TomtheCoder2/Maturitaetsarbeit/README.md

# My Matura Project

### Code (laptop)
[here](/code)
[main](/code/src/bin/live_feed.rs)

### Code (arduino)
[here](/arduino_code/cpp/)
[main](/arduino_code/cpp/stepper_motor/stepper_motor.ino)

### Code (CNN and other)
[here](/code/python_code_ma)

### Documentation
[here](/documentation)

### Notes
[here](/notes)
