TomtheCoder2/Maturitaetsarbeit/notes/notes.md

high speed cameras
* https://www.e-consystems.com/4k-usb-camera.asp

* from [reddit](https://www.reddit.com/r/computervision/comments/sghdp8/suggestions_for_usb_based_high_speed_cameras/):
    * FLIR: https://www.flir.com/products/a6700-mwir/?vertical=rd%20science&segment=solutions (idk but maybe too expensive
    * Basler: https://www.baslerweb.com/en/shop/daa720-520uc-no-mount/?sort=position (looks very good)
    * Allied Vision: https://www.alliedvision.com/de/produktportfolio/kameraselektor/detail/goldeye/g-034-xswir-22-tec2/ (too expensive)
    * The Imaging Source: https://www.theimagingsource.com/en-us/product/board/37u/dfm37ux287ml/
    * Baumer: https://www.baumer.com/ch/en/product-overview/industrial-cameras-image-processing/industrial-cameras/cx-series/vcxg-vcxu-cameras/global-shutter-cameras/vcxg/vcxg-04c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
    * Ximea: https://www.ximea.com/en/products/usb3-vision-cameras-xiq-line/mq003cg-cm
    * SVS Vistek: https://www.svs-vistek.com/en/industrial-cameras/svs-camera-detail.php?id=fxo421CCX12-2C
    * BFS-U3-04S2C-CS: 0,4 MP, 522 FPS, Sony IMX287, Farbe

* Motors
  * https://www.distrelec.ch/en/stepper-motor-4nm-3000min-sup-sup-nema-23-sanyo-denki-say/p/30235550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
  * dc motor: https://eckstein-shop.de/Pololu-101-Metal-Gearmotor-37Dx65L-mm-12V-with-64-CPR-Encoder-Helical-Pinion-EN  

* Found a set:
  * cam: Alvium 1800 C-040c: https://www.digikey.ch/de/products/detail/allied-vision-inc/14216/11594990
  * lens: f=2.8mm https://commonlands.com/products/glass-low-distortion-3mm-m12-lens

* Arduino stuff
  * Arduino Mega 2560: https://store.arduino.cc/products/arduino-mega-2560-rev3
  * driver for dc motor: https://www.reichelt.com/ch/de/entwicklerboards-motorsteuerung-2-fach-l298n-debo-drv1-l298n-p282644.html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
  * driver for stepper motor: https://www.reichelt.com/ch/de/entwicklerboards-schrittmotorsteuerung-a4988-debo-drv-a4988-p282646.html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
