TomtheCoder2/Maturitaetsarbeit/documentation/src/main.tex

% Preamble
\documentclass[11pt,openany, english]{book}
\usepackage[a4paper, total={6in, 8in},headsep=0.5cm]{geometry}

% Packages
\usepackage{amsmath}
\usepackage{tikz}
\usetikzlibrary{shapes.geometric, arrows}
\usetikzlibrary{decorations.markings}
\usetikzlibrary{decorations.pathmorphing,patterns}
\usepackage{wrapfig}
%\usepackage{amstex}
\usetikzlibrary{calc}
\usepackage{fancyheadings}
\usepackage{mathtools}
\usepackage{transparent}
\usepackage{graphicx}
\usepackage{float}
\usepackage{subcaption}
\usepackage [autostyle, english = american]{csquotes}
\usepackage{hyperref}
\usepackage{siunitx}
\hypersetup{
    colorlinks,
    linkcolor={blue!50!black},
    citecolor={blue!50!black},
    urlcolor={blue!80!black}
}
\usepackage{pgfplots}
\usepackage{pgfplotstable}
\usepackage{babel}[english]
\usepackage{cancel}
%\usepackage[super]{natbib}
\pgfplotsset{compat=1.12}
%\usepackage{biblatex}
\usepackage[backend=bibtex, urldate=long,
    sorting=none,
    maxnames=10,
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
    template,this,thread_local,throw,true,try,typedef,typeid,typename,
    union,unsigned,using,virtual,void,volatile,wchar_t,while
},
    keywordstyle=\color{PurpleKeyword},
    ndkeywords={
    std,string,vector,map,set,unordered_map,unordered_set,shared_ptr,
    unique_ptr,weak_ptr,array,optional,variant,tuple,pair,ostream,
    istream,cout,cin,endl
},
    ndkeywordstyle=\color{RedTypename},
    comment=[l][\color{GrayComment}\slshape]{//},
    morecomment=[s][\color{GrayComment}\slshape]{/*}{*/},
    stringstyle=\color{GreenString},
    string=[b]"
}

% get name of current section
\makeatletter
\newcommand*{\currentname}{\@currentlabelname}
\makeatother

% get name of current chapter
\let\Chaptermark\chaptermark
\def\chaptermark#1{\def\Chaptername{#1}\Chaptermark{#1}}

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

% #1 number of teeth
% #2 radius intern
% #3 radius extern
% #4 angle from start to end of the first arc
% #5 angle to decale the second arc from the first
\newcommand{\gear}[5]{%
    \foreach \i in {1,...,#1} {%
        [rotate=(\i-1)*360/#1]
        (0:#2) arc (0:#4:#2)
        [rounded corners=1.5pt]
        -- (#4+#5:#3)
        arc (#4+#5:360/#1-#5:#3)
        -- (360/#1:#2)
    }
}

\newcommand{\mycancel}[2]{\overset{#1}{\cancel{#2}}}
\newcommand{\cancelunder}[2]{\underset{#1}{\cancel{#2}}}
\renewcommand{\deg}[0]{\ensuremath{^\circ}}
\newcommand{\abs}[1]{\left|#1\right|}
\newcommand{\cfbox}[2]{%
    \colorlet{currentcolor}{.}%
    {\color{#1}%
    \noindent\fbox{\vbox{\hsize\dimexpr\hsize-2\fboxsep\relax
    #2
    }}}%
}
\newcommand{\todo}[1]{\begin{center}\cfbox{red}{\textcolor{red}{Todo: #1}}\end{center}}

\oddsidemargin=-1cm
\evensidemargin=-1cm
\voffset=-1.5cm
\textheight=26cm
\textwidth=18cm

\thispagestyle{fancy}

\fancyhf{} % clear all fields
\newcommand{\footl}{\Chaptername}
\newcommand{\bottompage}{-- \thepage\ --}

\date{\today}

\fancypagestyle{plain}{%
    \fancyhf{}
    \fancyhead[L]{\rule[-2ex]{0pt}{2ex}\small Matura Project}
    \fancyhead[R]{\small Jan Wilhelm, 6e}
    \fancyfoot[L]{\small \footl}
    \fancyfoot[C]{\bottompage}
    \fancyfoot[R]{\small \today}
    \renewcommand{\headrulewidth}{0.2pt}
    \renewcommand{\footrulewidth}{0.2pt}}
\pagestyle{plain}

\title{
    \linespread{1.8}
    Jan Wilhelm, 6e\\
    \linespread{1}
    \Huge \textbf{Designing, assembling and programming a foosball goalkeeper robot}\\
    \linespread{1.8}
    \vspace{0.5cm}
    \begin{figure}[H]
        \centering
        
        \caption*{}
        \label{fig:title}
    \end{figure}
    \vspace{-0.8cm}
    \Large
    \textbf{Maturitätsarbeit}\\
    Kantonsschule Hohe Promenade, Gymnasium, Zürich 2024/2025\\
    \textbf{Supervisor:} Clemens Pohle\\
    \textbf{Advisor:} Dr. Hugo Leonel Cabrera Cifuentes\\
    \linespread{1}}
% custom date 17.12.2024
%\date{December 17, 2024}

%\linespread{1.8}

% Document
\begin{document}

    \makeatletter
    \voffset=-1.5cm
    \begin{titlepage}
        \thispagestyle{fancy}
        \renewcommand{\headrulewidth}{0pt}
        \renewcommand{\footrulewidth}{0pt}
        \lhead{}
        \rhead{}
        \rfoot{}
        \cfoot{} % this is to remove the page number
        \hbox{}\vfill
        \begin{center}
        {\LARGE\@title}
            \\[3em]
            {\large\@author}\\[1.75em]
            {\large\@date}
        \end{center}
        \vspace{3cm}\vfill
    \end{titlepage}
    \makeatother
    \voffset=-2.0cm
    \textheight=26.4cm

    % todo: main questions: We/I or unpersonal?
    % -> I always use I
%    \maketitle
%    \mewpage

    \shipout\null

    \renewcommand{\bottompage}{}
    \tableofcontents
    \newpage

    ~\\
    \section*{Abstract}
    \begin{abstract}
        Whether a machine can beat a human in a specific task is as old as the first machines.
        Machines have already surpassed humans in many areas, such as calculators, chess,
        and even driving cars.
        But what about foosball (table soccer)?
        This project demonstrates the development of a machine-controlled goalkeeper for foosball,
        capable of reliably stopping slow balls.
        While the goalkeeper occasionally struggles with the timing required for fast balls and shooting,
        the results serve as a proof of concept.
        The machine uses a camera to monitor the game from below and motors to move the goalkeeper.
        Although only basic AI was employed,
        the approach shows promise for extending similar designs to other players on the table.
        This work highlights the potential of automated systems in fast-paced, real-time scenarios,
        while acknowledging room for improvement to enhance performance and timing.
    \end{abstract}
    \vspace{1cm}

    \section*{Acknowledgements}
    I would like to express my heartfelt gratitude to the following individuals and organizations for their invaluable support and contributions to my project:
    \begin{enumerate}
        \item My parents, Bettina Jenny und Dirk Wilhelm
        \begin{itemize}
            \vspace{-0.2cm}
            \item Email: \href{mailto:wilk@zhaw.ch}{wilk@zhaw.ch} (Father) \& (private) (Mother)
            \item Contribution: Financial support, technical advice, and encouragement throughout this journey.
            \vspace{-0.2cm}
        \end{itemize}
        \item Ilena Teng and her father Robert Teng
        \begin{itemize}
            \vspace{-0.2cm}
            \item Email: (private)
            \item Contribution: Technical assistance with soldering and sensor integration.
            \vspace{-0.2cm}
        \end{itemize}
        \item FabLab Zürich
        \begin{itemize}
            \vspace{-0.2cm}
            \item Email: \href{mailto:vorstand@zurich.fablab.ch}{vorstand@zurich.fablab.ch}
            \item Contribution: Providing access to laser cutting, 3D printing, and CNC machining, and helpful guidance by the team members.
            \vspace{-0.2cm}
        \end{itemize}
        \item Gabriel Schneider from ZHAW
        \begin{itemize}
            \vspace{-0.2cm}
            \item Email: \href{mailto:gabriel.schneider@zhaw.ch}{gabriel.schneider@zhaw.ch}
            \item Contribution: Expertise and support in the design process.
            \vspace{-0.2cm}
        \end{itemize}
        \item Clemens Pohle, my supervisor
        \begin{itemize}
            \vspace{-0.2cm}
            \item Email: \href{mailto:clemens.pohle@kshp.ch}{clemens.pohle@kshp.ch}
            \item Contribution: Continuous supervision and insightful feedback, which greatly improved the quality of this documentation.
            \vspace{-0.2cm}
        \end{itemize}
    \end{enumerate}
    Thank you all for your generosity and dedication, which made this project possible.

    \vspace{1cm}
    \section*{Statement of Originality}
    Ich, Jan Wilhelm aus der Klasse 6e, erkläre hiermit, dass ich die vorliegende Arbeit "Designing, assembling and programming a foosball goalkeeper robot" selbständig und ohne Benützung anderer als der angegebenen Quellen oder Hilfsmittel verfasst bzw. gestaltet habe.
    \vspace{1cm}\\
    Ort, Datum: \hspace{6cm} Unterschrift:

    \chapter{Introduction}\label{ch:introduction}
    \renewcommand{\bottompage}{-- \thepage\ --}
    \setcounter{page}{1}
    \input{introduction}

    \chapter{Objectives}\label{ch:objectives}
    \input{objectives}

    \chapter{Calculations}\label{ch:calculations}
    \input{calculations}

    \chapter{Mechanics}\label{ch:mechanics}
    \input{mechanics}

    \chapter{Construction}\label{ch:construction}
    \input{construction}

    \chapter{Electronics}\label{ch:electronics}
    \input{electronics}

    \chapter{Software}\label{ch:software}
    \input{software}

    \chapter{Results}\label{ch:results}
%    \todo{Finish project to get latest results}
    \input{results}

    \chapter{Conclusion}\label{ch:conclusion}
    \input{conclusion}

    \newpage
    \renewcommand{\footl}{References}

    \bibliographystyle{abbrv}
    \printbibliography

%    \newpage
%    \bibliographystyle{unsrt}
%%    \renewcommand\refname{Quellen}
%    \makeatletter
%    \renewcommand\@biblabel[1]{\textbullet}
%    \makeatother
%    \bibliography{sources} % Entries are in the refs.bib file
%    \printbibliography
%    \nocite{*}

    \newpage

    \chapter{Appendix}\label{ch:appendix}
    \renewcommand{\footl}{\Chaptername}
    \input{appendix}

\end{document}

% pdflatex -interaction=nonstopmode -output-directory=output src/main.tex
