TomtheCoder2/Maturitaetsarbeit/documentation/src/foosball_system.tex

%! Author = janwi
%! Date = 01.12.2024

%! Author = janwi
%! Date = 19.11.2024

% Preamble
\documentclass[11pt]{article}
\usepackage[a4paper, total={6in, 8in},headsep=1cm]{geometry}
\usepackage{fancyhdr}
\usepackage[german]{datetime}
\usepackage{amsmath}
\usepackage{blindtext}
\usepackage{tikz}

\newdate{date}{19}{11}{2024}

\oddsidemargin=-1.5cm
\voffset=-1.7cm
\textheight=26cm
\textwidth=19cm

\fancyhf{} % clear all fields
\newcommand{\footl}{left bottom text}
\newcommand{\headl}{left top text}

\fancypagestyle{plain}{%
    \fancyhf{}
    \fancyhead[L]{\rule[-2ex]{0pt}{2ex}\small \headl}
    \fancyhead[R]{\small Jan Wilhelm 6e}
    \fancyfoot[L]{\small \footl}
    \fancyfoot[C]{-- \thepage\ --}
    \fancyfoot[R]{\small \date{\displaydate{date}}}
    \renewcommand{\headrulewidth}{0.2pt}
    \renewcommand{\footrulewidth}{0.2pt}}
\pagestyle{plain}

\title {\vspace{-1.5cm} \huge \textbf {Title}\\
\newdateformat\date{\displaydate{date}}
}

% #1 number of teeth
% #2 radius intern
% #3 radius extern
% #4 angle from start to end of the first arc
% #5 angle to decale the second arc from the first
\newcommand{\gear}[5]{%
    \foreach \i in {1,...,#1} {%
        [rotate=(\i-1)*360/#1]
        (0:#2) arc (0:#4:#2)
        [rounded corners=1.5pt]
        -- (#4+#5:#3)
        arc (#4+#5:360/#1-#5:#3)
        -- (360/#1:#2)
    }
}

% Document
\begin{document}
    \vspace{-1cm}
    \maketitle
    \vspace{-1cm}

    % create a simple drawing of the system
    \begin{center}
        \begin{tikzpicture}
            \draw (7, 10) rectangle (0, 0);
            \begin{scope}
                [shift={(3.5, 0)}]
                \node[below] {Foosball table};
            \end{scope}
%        draw a circle in the middle and an arrow pointing there labling it the camera
            \draw[fill=blue!30] (3.5, 5) circle (0.5);
            \draw[<-] (4.1, 5) -- (8, 5) node[above] {Camera};
%            pc
            \draw[fill=orange!30] (10, 9) rectangle (12, 11) node[pos=0.5] {PC}
%            cable from camera to pc
            \draw[->] (3.5, 5.5) -- (3.5, 6) -- (11, 6) -- (11, 8.8);
%            controler (Arduino)
            \draw[fill=orange!30] (6, 10) rectangle (9, 11) node[pos=.5]{Controller unit};
            \draw[->] (10, 10.5) -- (9.2, 10.5);
%            move motor
            \draw[fill=blue!30] (7, 6.5) rectangle (8.5, 8) node[pos=.5,
text width=1.5cm,align=center
] {Move motor}
            \begin{scope}
                [shift={(7.75, 7.25)}, scale=0.4]
                \draw \gear{18}{2}{2.4}{10}{2}
            \end{scope}
            \draw[fill, black] (7.75, 7.25) circle (0.03);
            \draw[<-](7.75, 8.2) -- (7.75, 10);
            \draw (0, 8.75) rectangle (9, 8.25) node[pos=.5] {Tube};
            \draw[fill=blue!30] (0, 9.25) rectangle (-1, 7.75) node[midway, left, shift={(-.5, 0)}] {Shoot motor};
            \draw[->] (6, 10.5) -- (-0.5, 10.5) -- (-0.5, 9.45);
            \draw (3.5, 8.5) circle (0.5);
        \end{tikzpicture}
    \end{center}

\end{document}
