TomtheCoder2/Maturitaetsarbeit/documentation/src/data_matracies.tex

\documentclass[11pt]{report}
\usepackage{graphics}
\usepackage{graphicx}

\textheight=21cm
\oddsidemargin=-2.5cm
\textwidth=18.5cm

\begin{document}
    \setlength{\fboxsep}{0pt}%
    \setlength{\fboxrule}{1pt}%

    \begin{table}[]
        \begin{tabular}{ll}
            \fbox{}
            &  \fbox{} \\
            &                                                       \\
            \fbox{}
            & \fbox{} \\

        \end{tabular}
    \end{table}

\end{document}
