TomtheCoder2/Maturitaetsarbeit/code/formulas/img_1.png

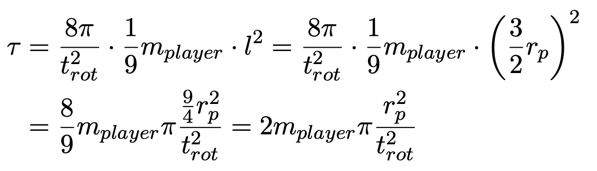
code/formulas/img_1.png
