TomtheCoder2/Maturitaetsarbeit/code/output.png

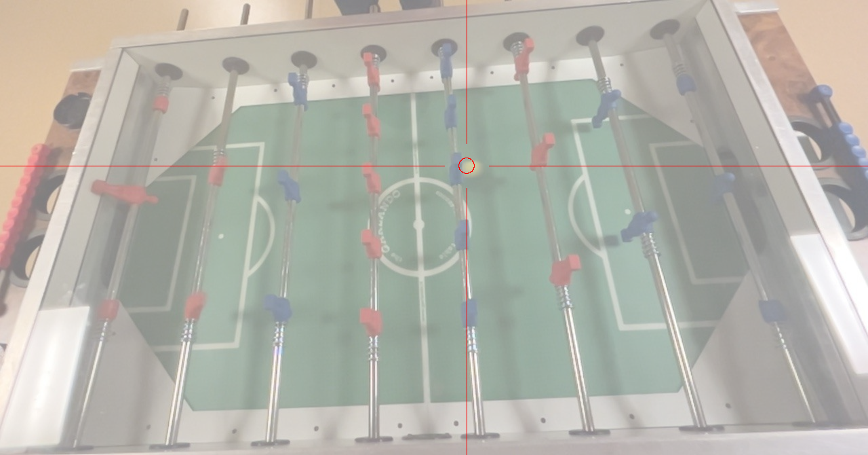
code/output.png
