TomtheCoder2/Maturitaetsarbeit/code/python_code_ma/base_img6.png

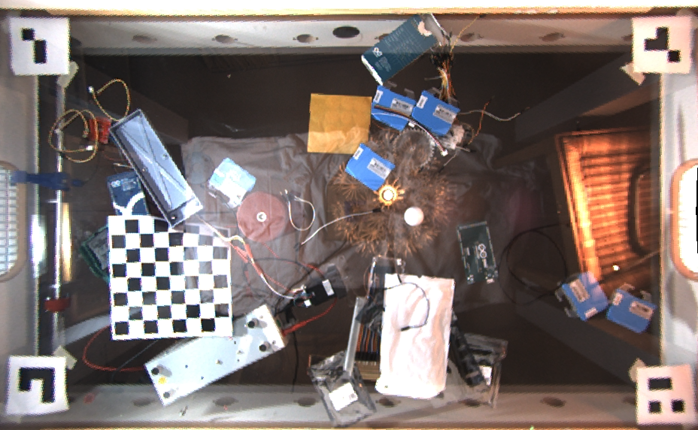
code/python_code_ma/base_img6.png
