TomtheCoder2/Maturitaetsarbeit/code/raw.jpg

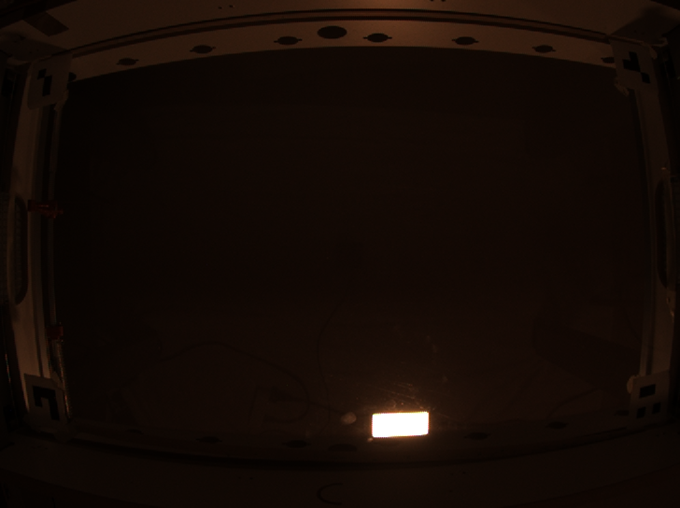
code/raw.jpg
