TomtheCoder2/Maturitaetsarbeit/code/src/gpu/input_image.png

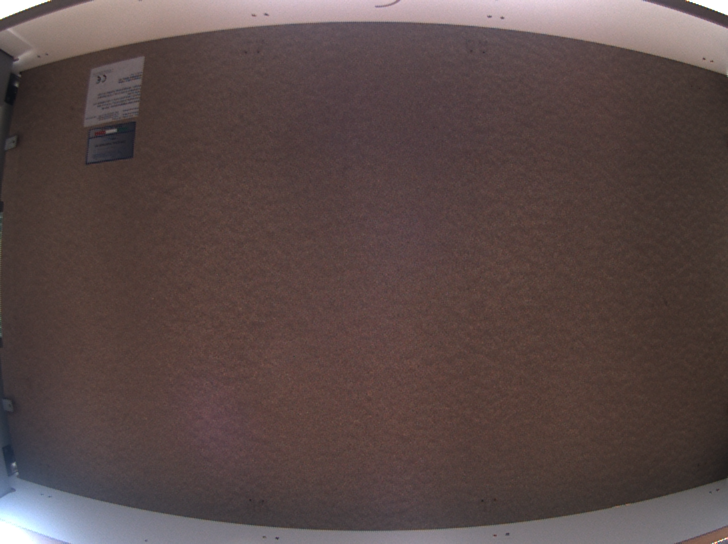
code/src/gpu/input_image.png
