TomtheCoder2/Maturitaetsarbeit/code/src/gpu/output_image.png

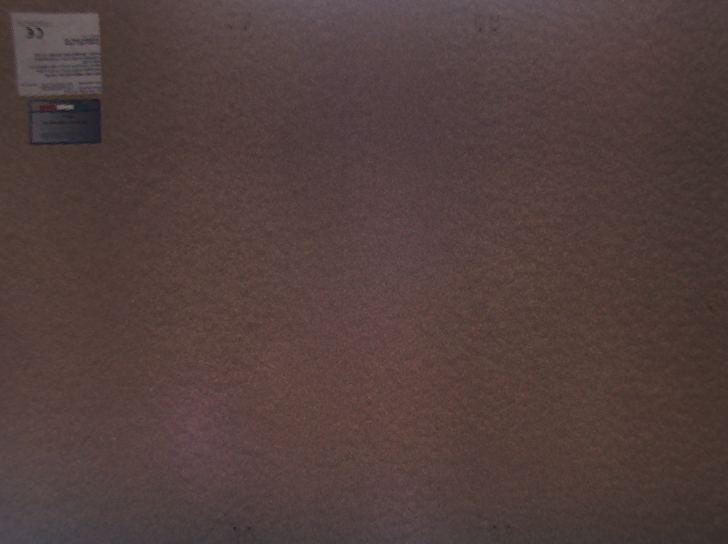
code/src/gpu/output_image.png
