TomtheCoder2/Maturitaetsarbeit/documentation/images/datamatrix_0.png

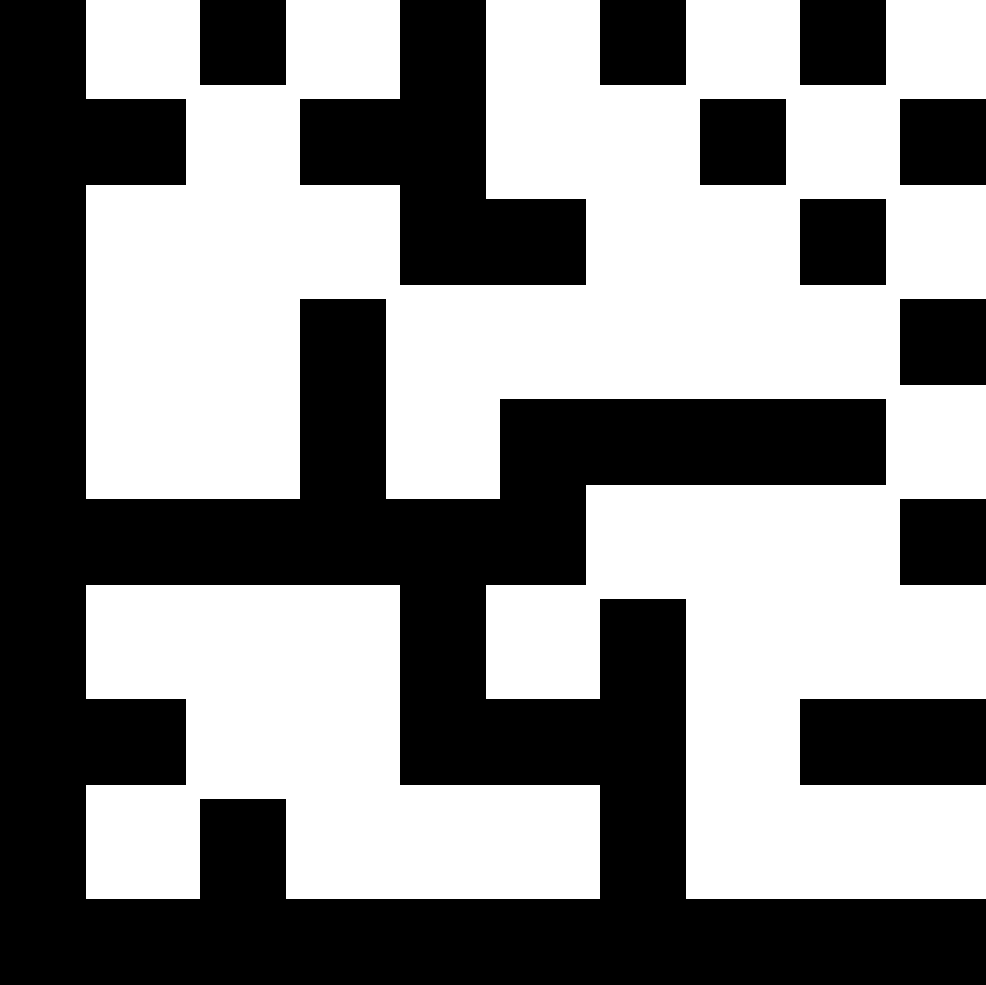
documentation/images/datamatrix_0.png
