TomtheCoder2/Maturitaetsarbeit/documentation/images/datamatrix_1.png

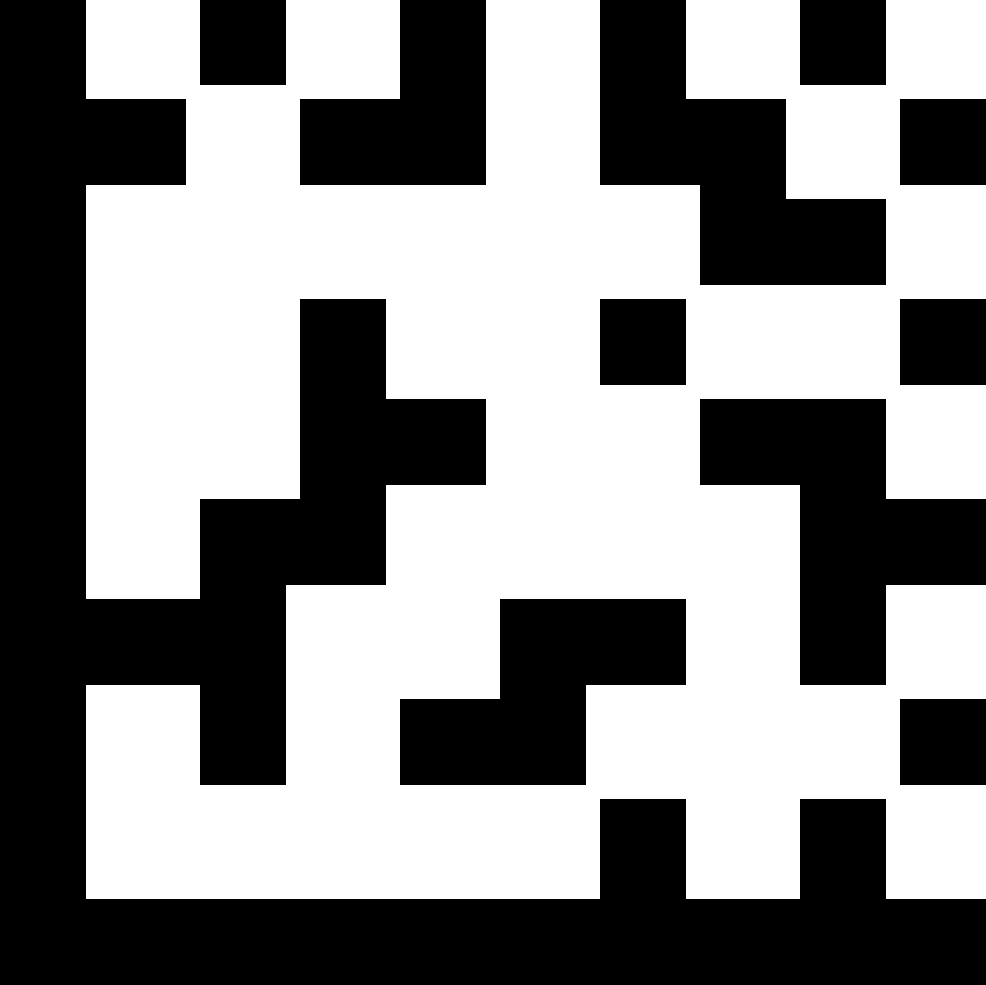
documentation/images/datamatrix_1.png
