TomtheCoder2/Maturitaetsarbeit/documentation/images/datamatrix_2.png

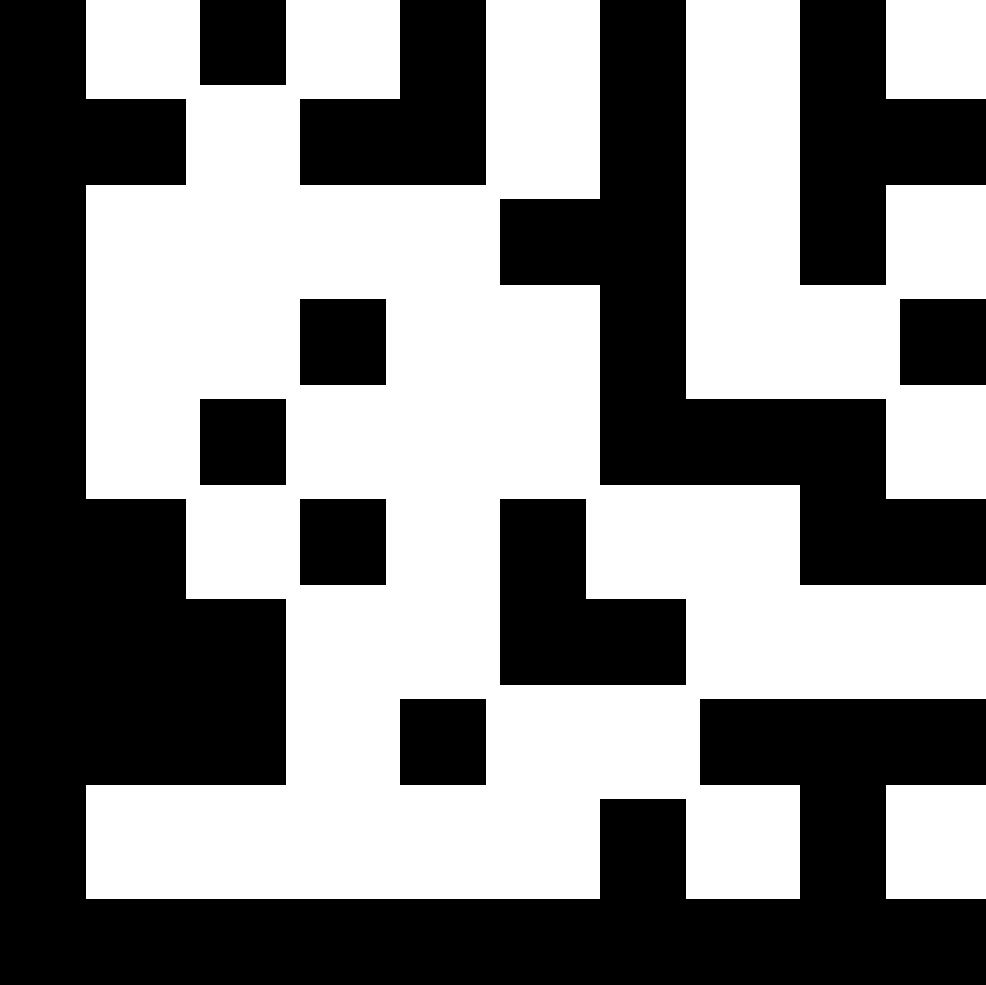
documentation/images/datamatrix_2.png
