TomtheCoder2/Maturitaetsarbeit/documentation/images/datamatrix_3.png

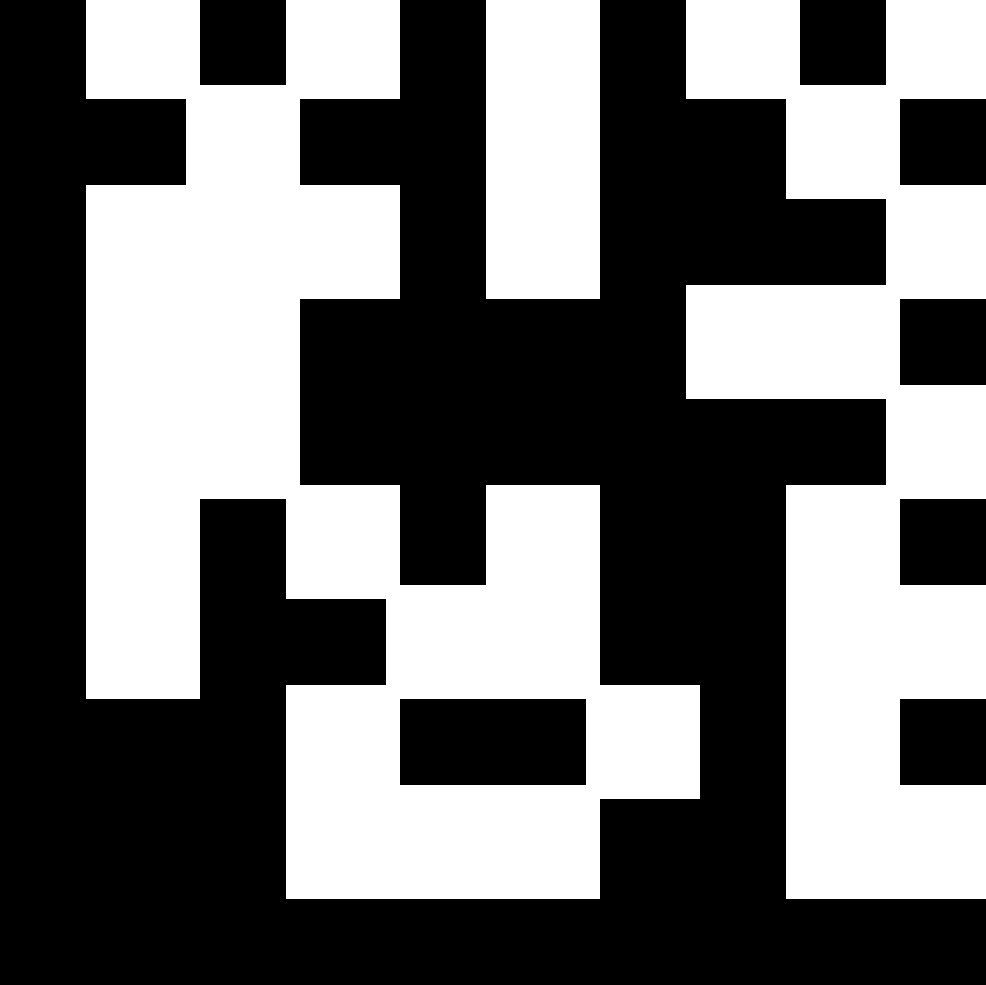
documentation/images/datamatrix_3.png
