TomtheCoder2/Maturitaetsarbeit/documentation/photos/cnc_shield_c.jpeg

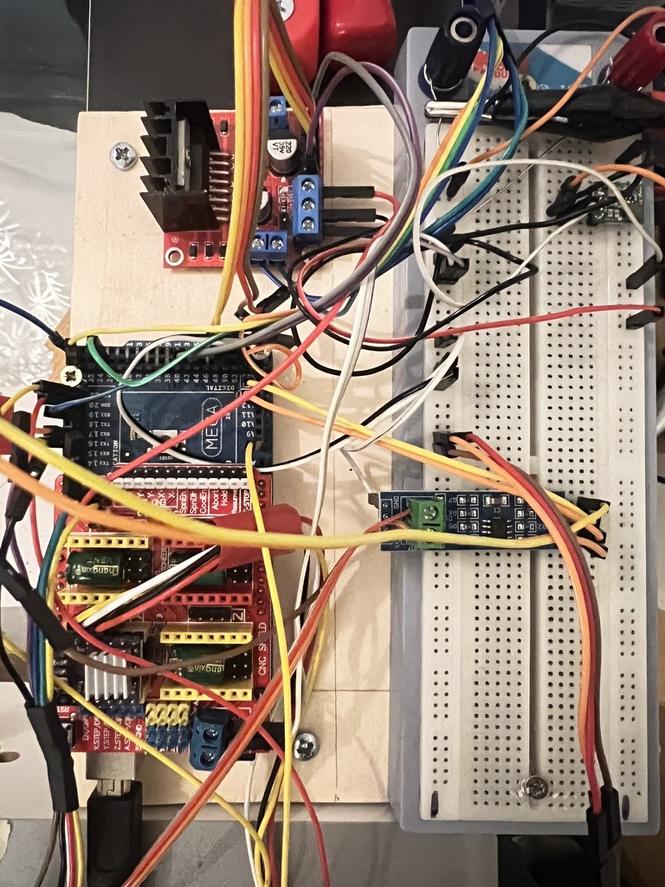
documentation/photos/cnc_shield_c.jpeg
