TomtheCoder2/Maturitaetsarbeit/documentation/photos/example8_cropped.png

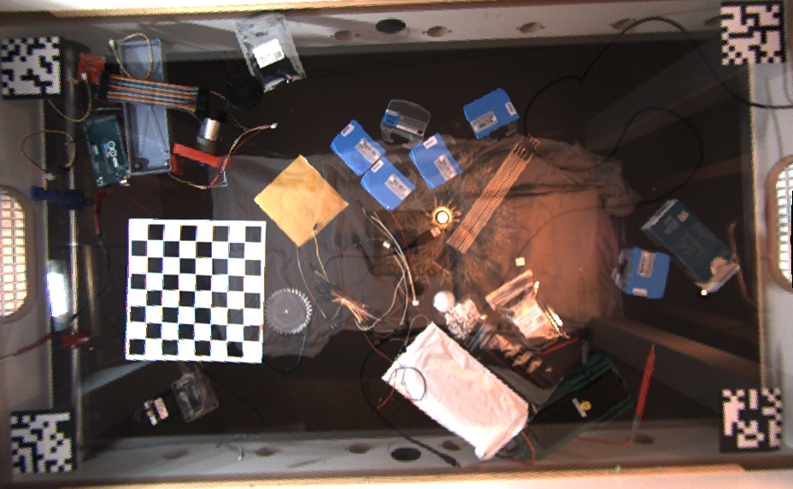
documentation/photos/example8_cropped.png
