TomtheCoder2/Maturitaetsarbeit/documentation/photos/foosball_player.png

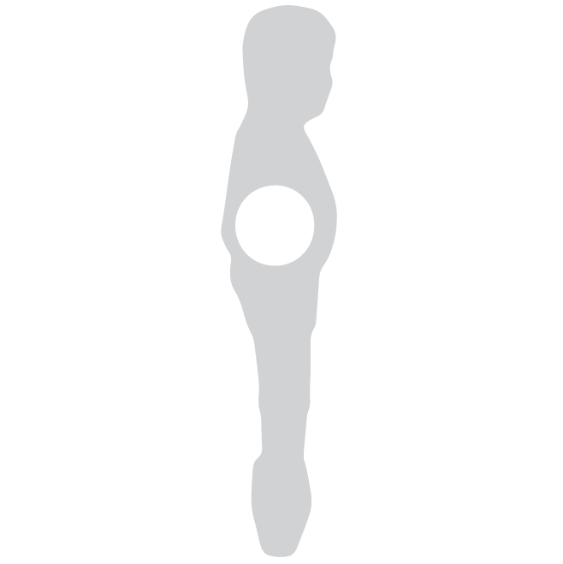
documentation/photos/foosball_player.png
