TomtheCoder2/Maturitaetsarbeit/documentation/photos/original_example8.png

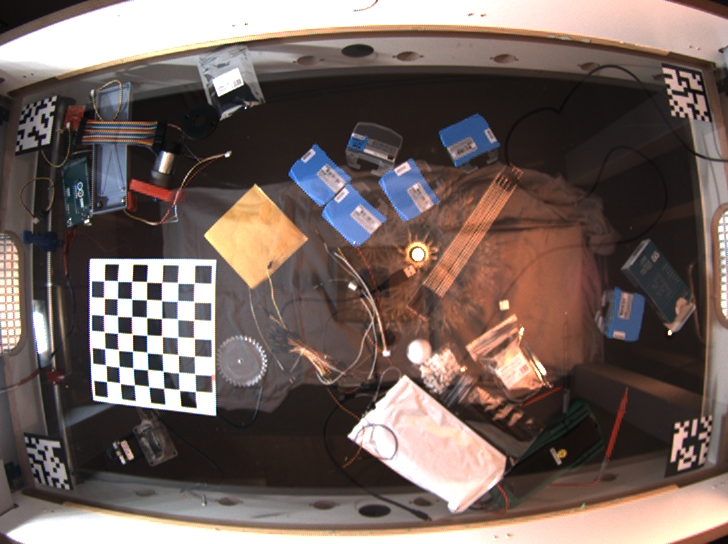
documentation/photos/original_example8.png
