TomtheCoder2/Maturitaetsarbeit/documentation/photos/turn_side2.png

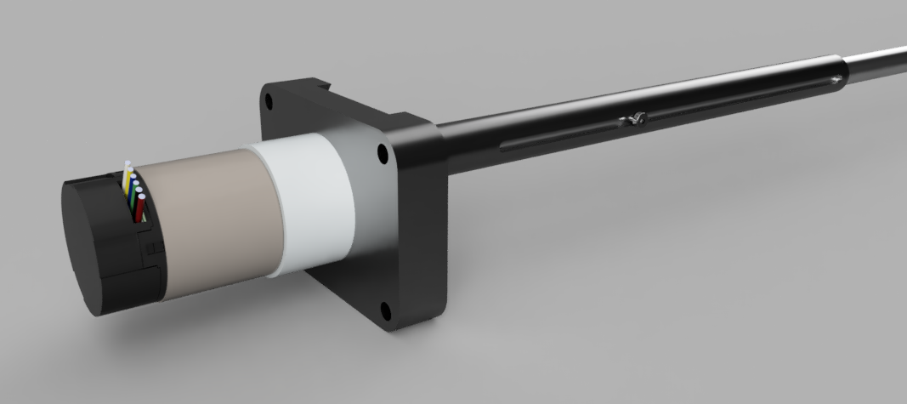
documentation/photos/turn_side2.png
