TomtheCoder2/Maturitaetsarbeit/code/calibration_pictures/image2.png

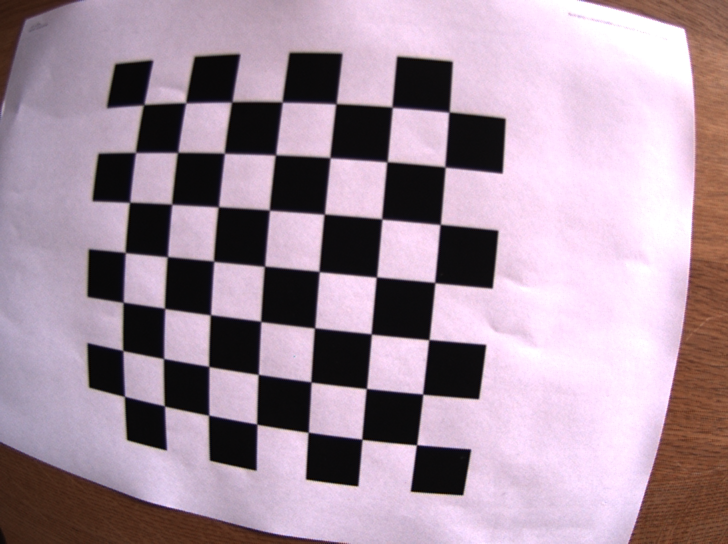
code/calibration_pictures/image2.png
