TomtheCoder2/Maturitaetsarbeit/(commit log)

2024-02-29 added pneumatic stuff
2024-09-04 trying to read from buffer, not encoding correctly rn
    [arduino_laptop.rs]
2024-12-08 code fix shooting, arduino_code
    [live_feed.rs]
2024-12-10 ir sensor, fixes
2025-01-19 poster and rs fixes
    [arduino_com.rs, arduino_laptop.rs, ball.rs, live_feed.rs, rs485_test.ino, stepper_motor.ino]
2025-11-03 new script for arduino
2025-11-04 new pid variables
